SimonFlower/BoatEnvironmentMonitor/README.md

## Introduction

This project contains software to run an environmental monitor for a boat
and send the data over a mobile modem to an MQTT broker. The computer used
for the project is a Nucleo-32 STM32L432 development board which uses the
STM32L432KCU6 ARM microprocessor.

During development the Nucleo board attaches to a host computer by USB. When
USB is connected two devices will be created on the host computer:

1. A mass storage device. Programs are uploaded to the board by copying a
   file with the .bin suffix (any filename can be used) to this device.
   The makefile in this project generates a file called build/app.bin.
2. A serial port. The serial port is used to monitor debugging output
   from the program. It can also be used with a debugger.

This project was built using Linux Debian 13. All examples in this
documentation use Linux commands.

## Useful documentatation

- STML432 processor manual: 
  https://www.st.com/resource/en/reference_manual/rm0394-stm32l41xxx42xxx43xxx44xxx45xxx46xxx-advanced-armbased-32bit-mcus-stmicroelectronics.pdf
- Nucleo STML432 development board manual:
  https://www.st.com/resource/en/user_manual/um1956-stm32-nucleo32-boards-mb1180-stmicroelectronics.pdf
- Clipper 4G LTE Modem board schematic:
  https://cdn.shopify.com/s/files/1/0174/1800/files/lte_breakout_schematic.pdf
- A7682E modem module hardware and software manuals (downloads require login):
  https://en.simcom.com/product/A7683E.html
- DHT22 manual: https://cdn-shop.adafruit.com/datasheets/Digital+humidity+and+temperature+sensor+AM2302.pdf

## Installing and configuring build software

The hardware is configured and the routines to access the STM32L432 resources
are created using ST Microelectronics CubeMX software. Download
here: https://www.st.com/en/development-tools/stm32cubemx.html. The downloaded
zip contains a README describing how to install the software. The software can
be installed to a user (un-privleged) location. The state of the CubeMX project
is stored in the file BoatEnvironmentalMonitor.ioc.

CubeMX manages installation of all library software needed by the project.
When hardware has been configured, you can get CubeMX to generate C source code with
placeholders for writing the application code. Provided you use these placeholders,
updates to hardware configuration can be written out as updated source code by CubeMX.
This CubeMX configuration is set to use "make" as the build tool - CubeMX also
manages the project's Makefile.

The following software is needed for building and debugging the program:

```
  sudo apt install -y \
    build-essential \
    git \
    make \
    gcc-arm-none-eabi \
    binutils-arm-none-eabi \
    gdb-multiarch \
    openocd \
    stlink-tools \
    ddd \
    picocom
```

Examples in this document assume you are using ddd for debugging and
picocom as a terminal emulator that will allow access to
'console' output from the Nucleo board over its USB serial port:

If you need a source code editor:

```
  sudo apt install -y geany geany-plugins
```

To allow st-flash and openocd to communicate with the Nucleo board over USB without requiring sudo, create a udev rule file for ST-LINK devices. Enter this text in /etc/udev/rules.d/99-stlink.rules

```
  SUBSYSTEMS=="usb", ATTRS{idVendor}=="0483", ATTRS{idProduct}=="374b", MODE="0666", GROUP="plugdev"
```

Reload udev rules and add your user account to the plugdev group:

```
  sudo udevadm control --reload-rules
  sudo udevadm trigger
  sudo usermod -aG plugdev $USER
```

Log out and back in for group membership to take effect.

To allow access to the serial port created by the Nucleo USB connection, add
your user to the 'dialout' group:

```
  sudo usermod -aG dialout $USER
```

To allow access to the ST-LINK programmer:

```
  sudo usermod -aG plugdev $USER
```

## Project structure

All commands in this README assume a current directory of "BoatEnvironmentalMonitor".

CubeMX creates this structure:

```
    BoatEnvironmentMonitor/
    ├── CubeMX
		├── Makefile
		├── STM32L432KCXx_FLASH.ld			
		├── startup_stm32l432kc.s
		├── Core/
		│   ├── Inc/					(Generated header .h files)
		│   ├── Src/					(Generated source .c files)
		├── Drivers/					(ST Microelectronics libraries)    
			├── BSP                     (Board support for Nucleo development board)
			├── CMSIS                   (ST Microelectronics STM32L432 definitions)
			├── STM32L4xx_HAL_Driver    (ST Microelectronics HAL definitions)
```

All of the files in these folders are managed by the CubeMX. Files in these
folders should only be modified in sections marked for user code by CubeMX.
Note that the program's main() function is in CubeMX/Core/Inc/main.c.

Source code not managed by CubeMX is here:

```
    BoatEnvironmentalMonitor/
    ├── Makefile
    ├── Inc/					(Application header .h files)
    ├── Src/					(Application source .c files)
```

## Building the software

To build the software, set your current directory to the top level project
folder and type:

```
	make clean		# remove any previous build artefacts
	make			# build the software
	make flash		# upload the image to the Nucleo board
```

The build artefacts are in CubeMX/build/.

## Viewing debug output

The file inc/debug.h defines whether debugging code is built into the program. Debugging
includes writing messages to the Nucleo development boards UART (serial port). These can
be viewed as follows:

Find the serial port created by the USB connection to the Nucleo board:

```
  ls /dev/ttyACM* /dev/ttyUSB* 2>/dev/null
```

Nucleo boards almost always enumerate as /dev/ttyACM0 (or /dev/ttyACM1 
if another device is connected). Assuming that the serial port created 
was /dev/ttyACM0, connect to the Nucleo board like this:

```
  picocom -b 115200 /dev/ttyACM0 
```

## Using the ST-LINK debugger

The Nucleo-32 development board includes the ST-LINK debugger. To access
the debugger, run openocd to connect to the ST-LINK, then run ddd to
provide a friendly user iterface to the debugger.

Run openocd as a background service. You need to do this each time you
start the computer that runs your development environment. The configuration
files are found in /usr/share/openocd/scripts/. This command will block
the terminal where it's issued (unless you terminate it with '&' to place
it in the background):

```
   openocd -f interface/stlink-v2-1.cfg -f target/stm32l4x.cfg
```

NOTE: Once openocd is running, don't use the "make flash" command,
as the underlying st-flash program requires the same USB interface
as openocd. Instead use the debuggers "load" command to upload a
newly compiled program onto the board (see below for an example of
using "load").

Next run ddd, telling it where to find the program being used on
the Nucleo-32 development board:

```
   ddd --debugger gdb-multiarch build/app.elf
```

Inside the ddd command console (at the "gdb" prompt) enter these commands:

```
    target remote localhost:3333    # connect to openocd
    monitor reset halt              # restart
    load                            # upload the program to the Nucleo board
```

You can now place graphical breakpoints directly on lines of code, 
step through instructions, and view target RAM/registers.

## Draft MQTT payload details

Example:

```
{
    "date": "yyyy-mm-ddThh:mm:ss",
    "batteries": {
        "1": "xx.xV",
        "2": "xx.xV",
        "3": "xx.xV"
    },
    "temperatures": {
        "1": "xx.xC",
        "2": "xx.xC",
        "3": "xx.xC",
        "4": "xx.xC",
        "5": "xx.xC"
    },
    "humidities": {
        "1": "xx.x%",
        "2": "xx.x%",
        "3": "xx.x%",
        "4": "xx.x%",
        "5": "xx.x%"
    },
    "mains_present": true
}
```

Size about 0.5Kb. Allow another 0.5Kb for MQTT set up = 1Kb every 15 minutes, or about 100Kb per day or about 3.5Mb per month.
