SimonFlower/BoatEnvironmentMonitor/Electronics/schematic.pdf

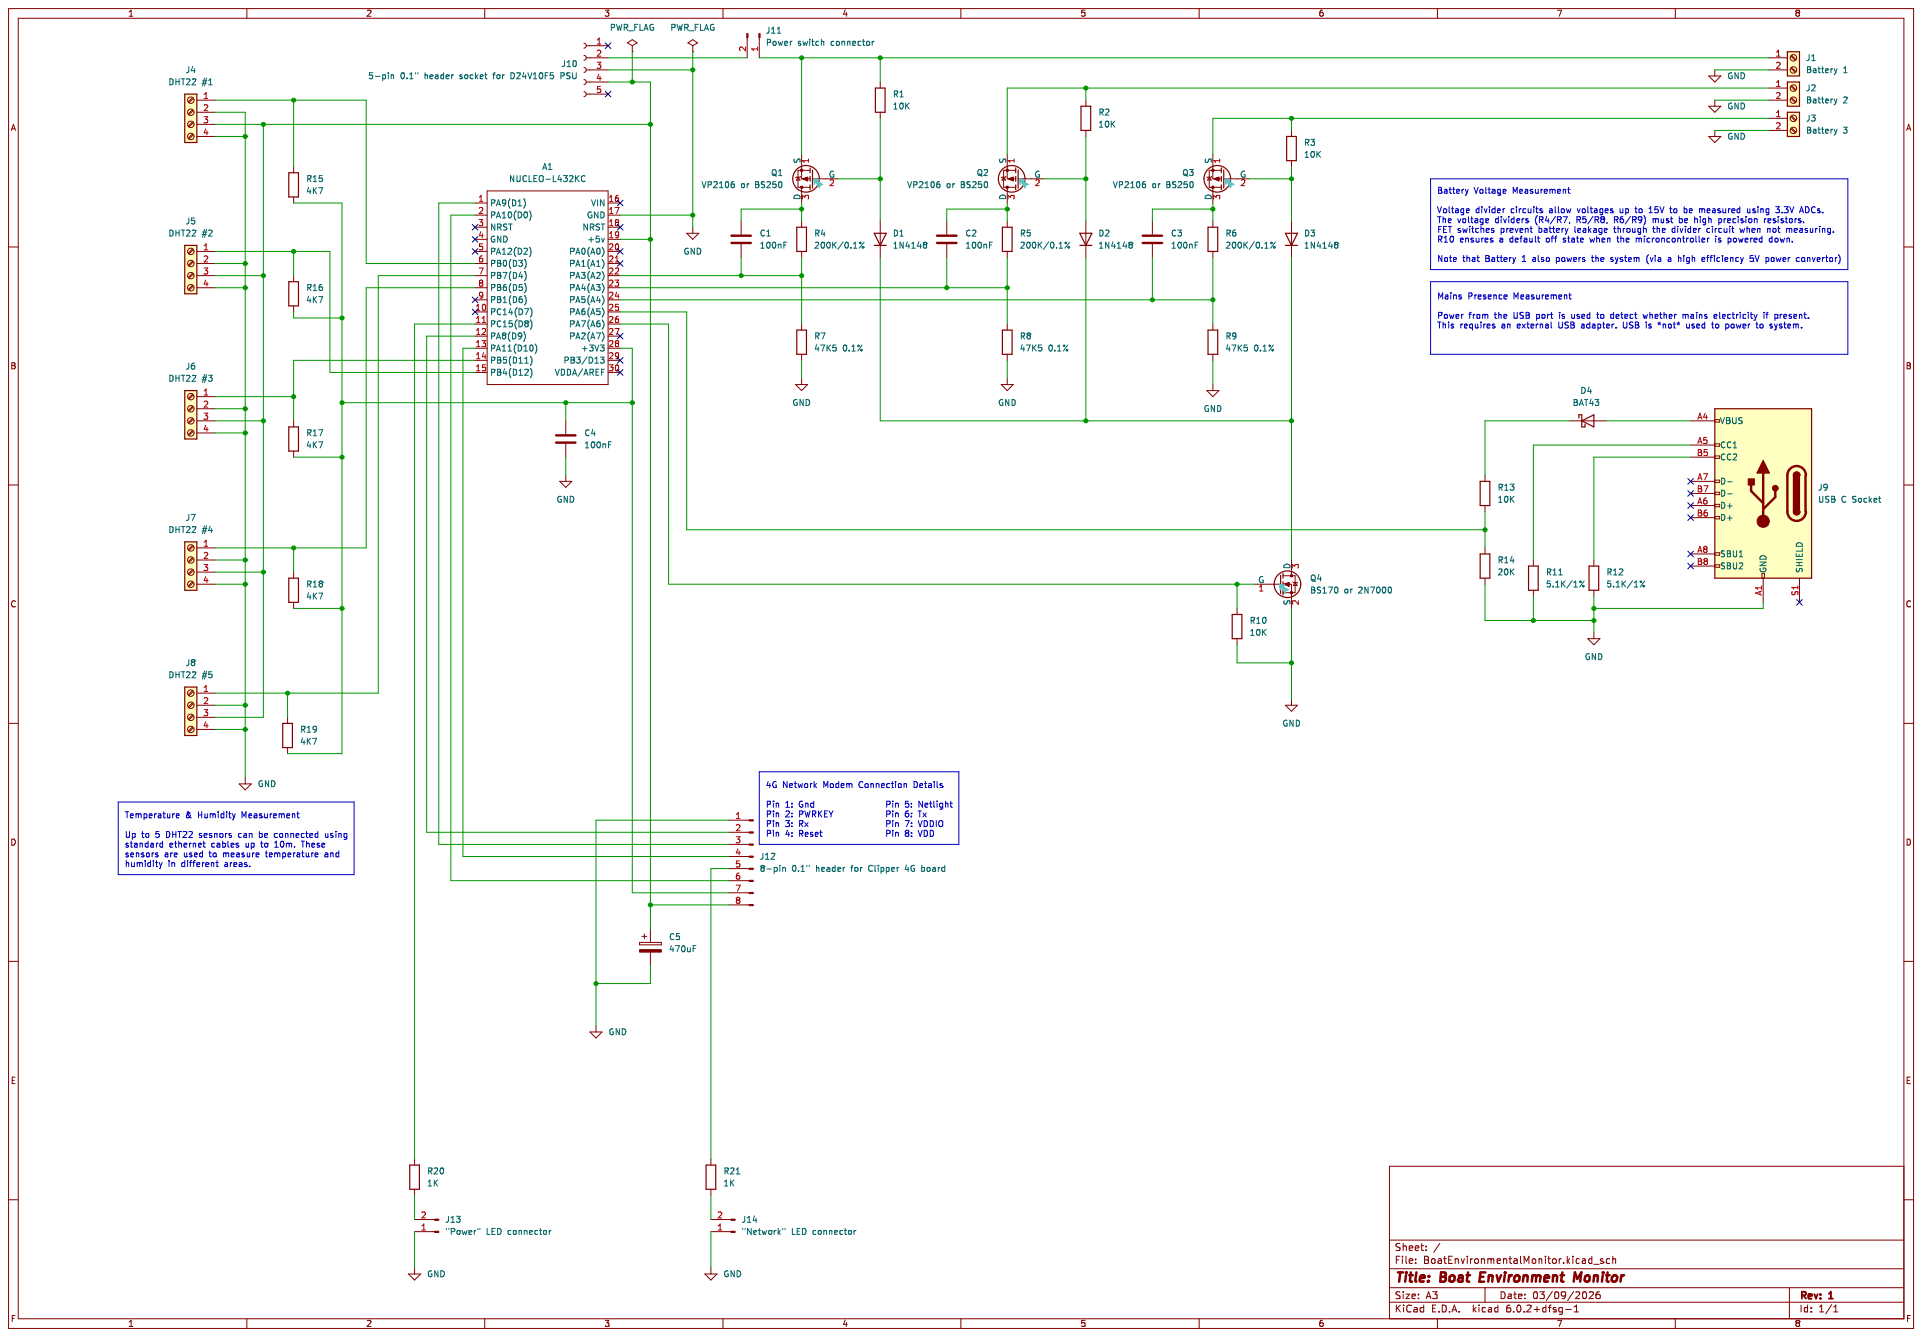
[picture p1: page 1]
