SimonFlower/BoatEnvironmentMonitor/Electronics/kicad/BoatEnvironmentalMonitor.kicad_sch

## KiCad design Electronics/kicad/BoatEnvironmentalMonitor.kicad_sch (2026-10-24)

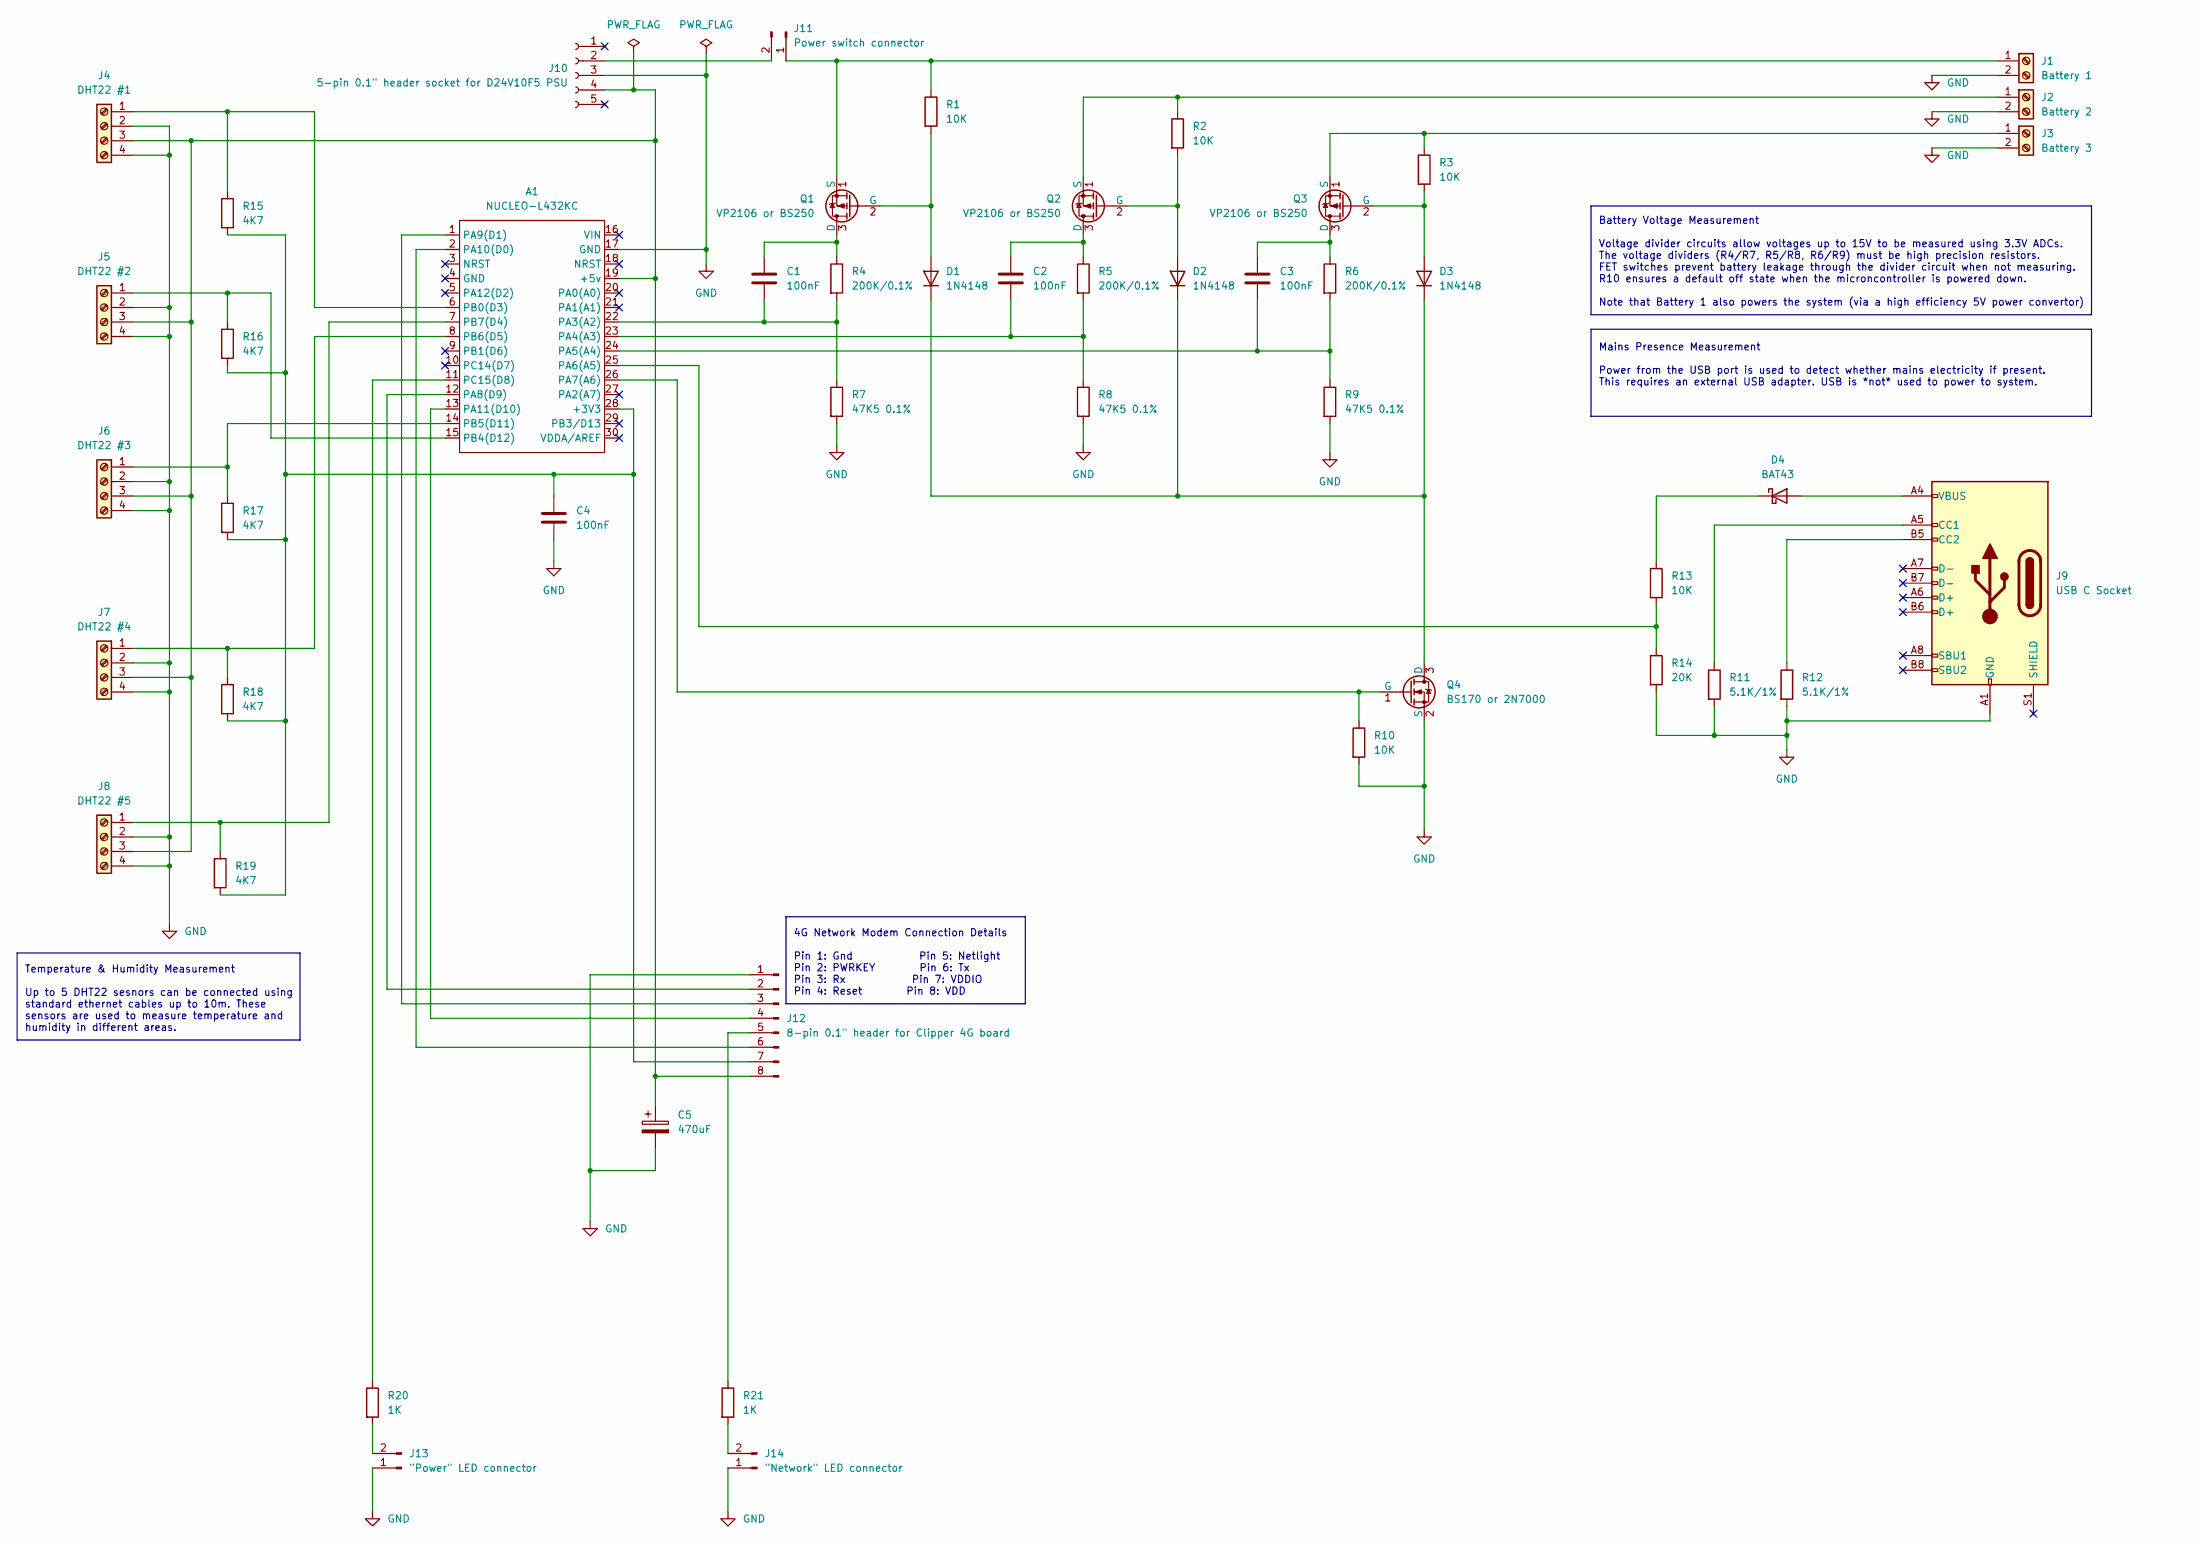
[picture p2: schematic BoatEnvironmentalMonitor.kicad_sch]

Parts:
A1: NUCLEO-L432KC
C1, C2, C3, C4: 100nF
C5: 470uF
D1, D2, D3: 1N4148; D_DO-35_SOD27_P7.62mm_Horizontal
D4: BAT43
J1: Battery 1
J2: Battery 2
J3: Battery 3
J4: DHT22 #1
J5: DHT22 #2
J6: DHT22 #3
J7: DHT22 #4
J8: DHT22 #5
J9: USB C Socket
J10: 5-pin 0.1" header socket for D24V10F5 PSU
J11: Power switch connector
J12: 8-pin 0.1" header for Clipper 4G board
J13: "Power" LED connector
J14: "Network" LED connector
Q1, Q2, Q3: VP2106 or BS250
Q4: BS170 or 2N7000
R1, R2, R3, R10, R13: 10K
R4, R5, R6: 200K/0.1%
R7, R8, R9: 47K5 0.1%
R11, R12: 5.1K/1%
R14: 20K
R15, R16, R17, R18, R19: 4K7
R20, R21: 1K

Connections:
GND: A1.17 (GND), C4.2, C5.2, J1.2, J2.2, J3.2, J4.2, J4.4, J5.2, J5.4, J6.2, J6.4, J7.2, J7.4, J8.2, J8.4, J9.A1 (GND), J9.A12 (GND), J9.B1 (GND), J9.B12 (GND), J10.3, J12.1, J13.1, J14.1, Q4.2 (S), R7.2, R8.2, R9.2, R10.2, R11.2, R12.2, R14.2
unnamed: A1.1 (PA9(D1)), J12.3
unnamed: A1.2 (PA10(D0)), J12.6
unnamed: A1.6 (PB0(D3)), J4.1, R15.1
unnamed: A1.7 (PB7(D4)), J8.1, R19.1
unnamed: A1.8 (PB6(D5)), J7.1, R18.1
unnamed: A1.11 (PC15(D8)), R20.1
unnamed: A1.12 (PA8(D9)), J12.2
unnamed: A1.13 (PA11(D10)), J12.4
unnamed: A1.14 (PB5(D11)), J6.1, R17.1
unnamed: A1.15 (PB4(D12)), J5.1, R16.1
unnamed: A1.19 (+5v), C5.1, J4.3, J5.3, J6.3, J7.3, J8.3, J10.4, J12.8
unnamed: A1.22 (PA3(A2)), C1.2, R4.2, R7.1
unnamed: A1.23 (PA4(A3)), C2.2, R5.2, R8.1
unnamed: A1.24 (PA5(A4)), C3.2, R6.2, R9.1
unnamed: A1.25 (PA6(A5)), R13.2, R14.1
unnamed: A1.26 (PA7(A6)), Q4.1 (G), R10.1
unnamed: A1.28 (+3V3), C4.1, J12.7, R15.2, R16.2, R17.2, R18.2, R19.2
unnamed: C1.1, Q1.3 (D), R4.1
unnamed: C2.1, Q2.3 (D), R5.1
unnamed: C3.1, Q3.3 (D), R6.1
unnamed: D1.1 (K), D2.1 (K), D3.1 (K), Q4.3 (D)
unnamed: D1.2 (A), Q1.2 (G), R1.2
unnamed: D2.2 (A), Q2.2 (G), R2.2
unnamed: D3.2 (A), Q3.2 (G), R3.2
unnamed: D4.1 (K), R13.1
unnamed: D4.2 (A), J9.A4 (VBUS), J9.A9 (VBUS), J9.B4 (VBUS), J9.B9 (VBUS)
unnamed: J1.1, J11.1, Q1.1 (S), R1.1
unnamed: J2.1, Q2.1 (S), R2.1
unnamed: J3.1, Q3.1 (S), R3.1
unnamed: J9.A5 (CC1), R11.1
unnamed: J9.B5 (CC2), R12.1
unnamed: J10.2, J11.2
unnamed: J12.5, R21.1
unnamed: J13.2, R20.2
unnamed: J14.2, R21.2

Notes on the sheet:
4G Network Modem Connection Details Pin 1: Gnd Pin 5: Netlight Pin 2: PWRKEY Pin 6: Tx Pin 3: Rx Pin 7: VDDIO Pin 4: Reset Pin 8: VDD
Temperature & Humidity Measurement Up to 5 DHT22 sesnors can be connected using standard ethernet cables up to 10m. These sensors are used to measure temperature and humidity in different areas.
Battery Voltage Measurement Voltage divider circuits allow voltages up to 15V to be measured using 3.3V ADCs. The voltage dividers (R4/R7, R5/R8, R6/R9) must be high precision resistors. FET switches prevent battery leakage through the divider circuit when not measuring. R10 ensures a default off s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
Mains Presence Measurement Power from the USB port is used to detect whether mains electricity if present. This requires an external USB adapter. USB is *not* used to power to system.
