SimonFlower/BoatEnvironmentMonitor/CubeMX/CubeMX.ioc

Mcu.UserName=STM32L432KCUx
PA0.GPIO_Label=MCO [High speed clock in]
PA0.Signal=RCC_CK_IN
PA10.Signal=USART1_RX
PA11.GPIO_Label=MODEM_RESET
PA11.Signal=GPIO_Output
PA2.GPIO_Label=VCP_TX
PA2.Signal=USART2_TX
PA3.GPIO_Label=BATTERY_1
PA3.Signal=ADCx_IN8
PA4.GPIO_Label=BATTERY_2
PA4.Signal=ADCx_IN9
PA5.GPIO_Label=BATTERY_3
PA5.Signal=ADCx_IN10
PA6.GPIO_Label=MAINS_USB
PA6.Signal=ADCx_IN11
PA7.GPIO_Label=FET_GATE_CTRL
PA7.Signal=GPIO_Output
PA8.GPIO_Label=MODEM_PWRKEY
PA8.Signal=GPIO_Output
PA9.Signal=USART1_TX
PB0.GPIO_Label=DHT22_1
PB0.Signal=GPIO_Output
PB5.GPIO_Label=DHT22_3
PB5.Signal=GPIO_Output
PB6.GPIO_Label=DHT22_4
PB6.Signal=GPIO_Output
PB7.GPIO_Label=DHT22_5
PB7.Signal=GPIO_Output
