SimonFlower/BoatEnvironmentMonitor/CubeMX/Core/Inc/main.h

#define MCO_Pin GPIO_PIN_0
#define MCO_GPIO_Port GPIOA
#define VCP_TX_Pin GPIO_PIN_2
#define VCP_TX_GPIO_Port GPIOA
#define BATTERY_1_Pin GPIO_PIN_3
#define BATTERY_1_GPIO_Port GPIOA
#define BATTERY_2_Pin GPIO_PIN_4
#define BATTERY_2_GPIO_Port GPIOA
#define BATTERY_3_Pin GPIO_PIN_5
#define BATTERY_3_GPIO_Port GPIOA
#define MAINS_USB_Pin GPIO_PIN_6
#define MAINS_USB_GPIO_Port GPIOA
#define FET_GATE_CTRL_Pin GPIO_PIN_7
#define FET_GATE_CTRL_GPIO_Port GPIOA
#define DHT22_1_Pin GPIO_PIN_0
#define DHT22_1_GPIO_Port GPIOB
#define MODEM_PWRKEY_Pin GPIO_PIN_8
#define MODEM_PWRKEY_GPIO_Port GPIOA
#define MODEM_RESET_Pin GPIO_PIN_11
#define MODEM_RESET_GPIO_Port GPIOA
#define SWDIO_Pin GPIO_PIN_13
#define SWDIO_GPIO_Port GPIOA
#define SWCLK_Pin GPIO_PIN_14
#define SWCLK_GPIO_Port GPIOA
#define VCP_RX_Pin GPIO_PIN_15
#define VCP_RX_GPIO_Port GPIOA
#define DHT22_2_Pin GPIO_PIN_4
#define DHT22_2_GPIO_Port GPIOB
#define DHT22_3_Pin GPIO_PIN_5
#define DHT22_3_GPIO_Port GPIOB
#define DHT22_4_Pin GPIO_PIN_6
#define DHT22_4_GPIO_Port GPIOB
#define DHT22_5_Pin GPIO_PIN_7
#define DHT22_5_GPIO_Port GPIOB
