SimonFlower/BoatEnvironmentMonitor/App/Inc/debug.h

/* This file is included in all source code. Set the constant DEBUG to 
 * a value between 0 and 5. Setting DEBUG to 0 will remove all debugging
 * code from the compiled program. Larger values of DEBUG increase the
 * amount of debugging output 
 * 
 * This file should be included before any other Boat Environment Monitor
 * include files, because some other include files use the DEBUG defintion */

#ifndef DEBUG_H
#define DEBUG_H

#define DEBUG 5

#if DEBUG > 0
void debug_init (void);
void diagnostics (void);
int __io_putchar(int ch);
#endif

#endif /* DEBUG_H */
