SimonFlower/BoatEnvironmentMonitor/(commit log)

2026-10-06 WIP: fixing modem technical debt
    [app.c, led.c, led.h, modem_at.c, modem_at.h, modem_ll.c, modem_ll.h]
2026-10-10 Add code to read DHT22 sensors
2026-10-16 WIP: Rearranging UART code
2026-10-17 Update UART code to work with multiple UARTs
2026-10-24 WIP: working on ADC
2026-10-24 Add electronics CAD files
